serpean/toyota-keys/3mf/avensis_3_botones.3mf

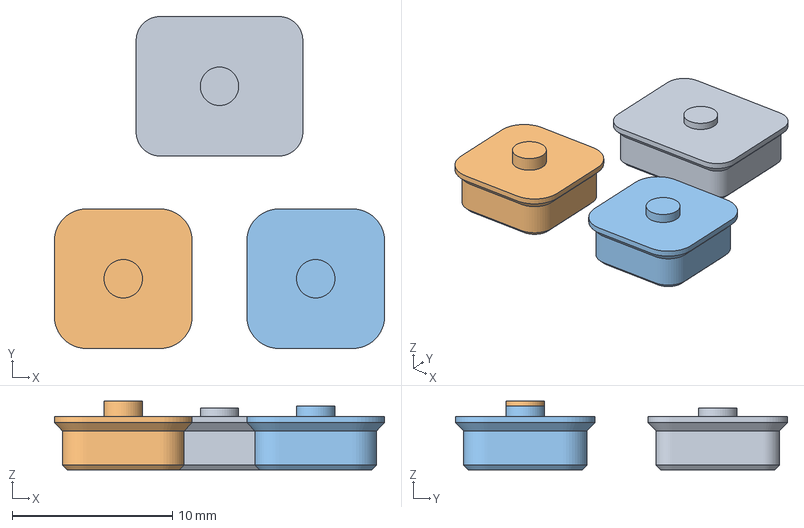
[picture p5: CAD file, 2026-11-06]
3mf/avensis_3_botones.3mf
20.6 x 20.7 x 4.30 mm
pieza_1
pieza_2
pieza_3
