serpean/toyota-keys/3mf/prueba_holgura_3_juegos.3mf

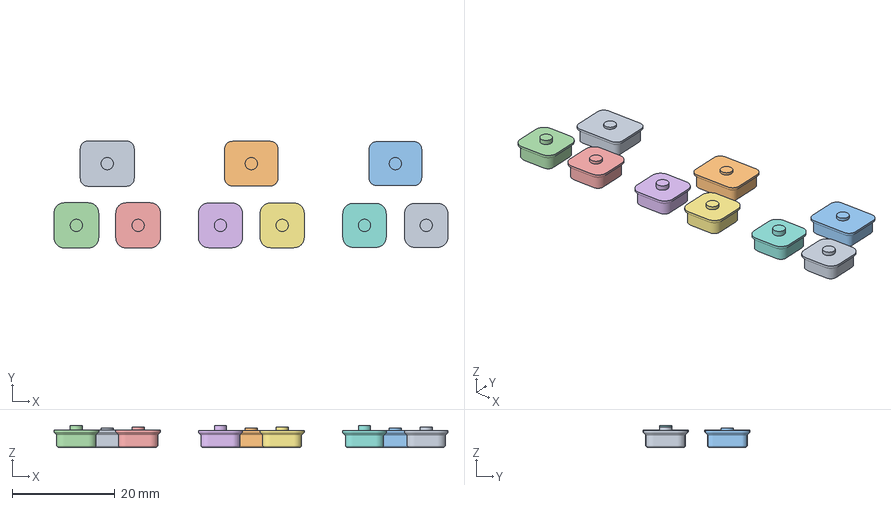
[picture p6: CAD file, 2026-11-06]
3mf/prueba_holgura_3_juegos.3mf
76.6 x 20.8 x 4.30 mm
pieza_1
pieza_2
pieza_3
pieza_4
pieza_5
pieza_6
pieza_7
pieza_8
pieza_9
