serpean/toyota-keys/3mf/boton_arriba_izq.3mf

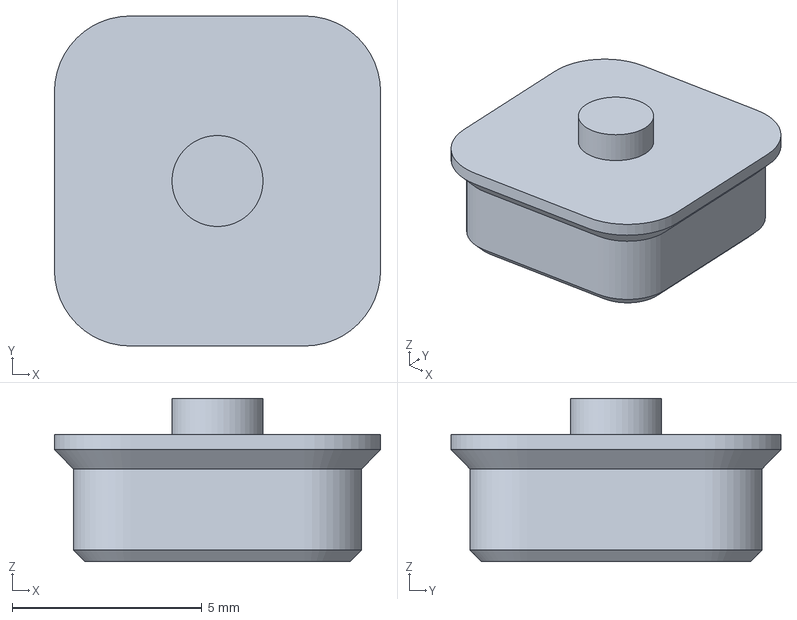
[picture p7: CAD file, 2026-11-06]
3mf/boton_arriba_izq.3mf
8.60 x 8.70 x 4.30 mm
