serpean/toyota-keys/3mf/boton_unlock.3mf

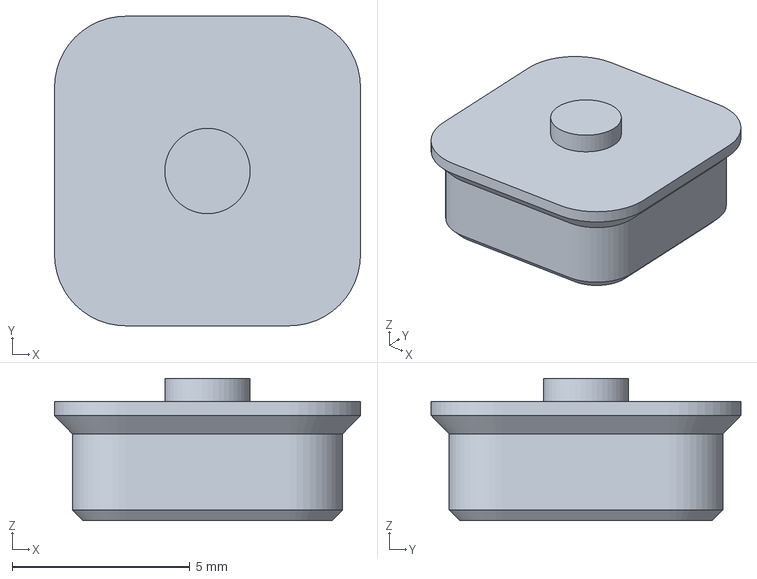
[picture p8: CAD file, 2026-11-06]
3mf/boton_unlock.3mf
8.60 x 8.70 x 4.00 mm
