serpean/toyota-keys/3mf/prueba_ancho_botones_arriba.3mf

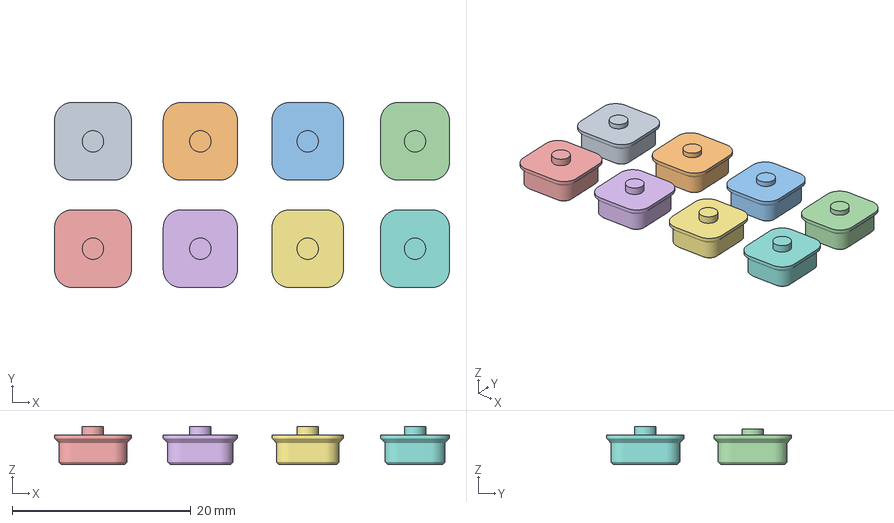
[picture p9: CAD file, 2026-11-06]
3mf/prueba_ancho_botones_arriba.3mf
44.2 x 20.7 x 4.30 mm
pieza_1
pieza_2
pieza_3
pieza_4
pieza_5
pieza_6
pieza_7
pieza_8
