serpean/toyota-keys/3mf/botones_arriba.3mf

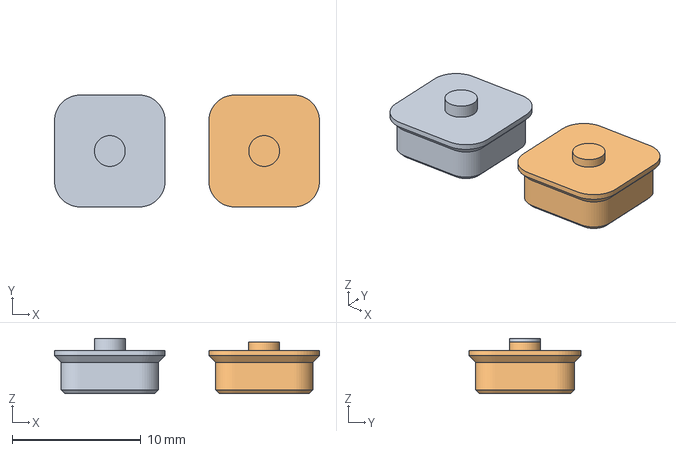
[picture p10: CAD file, 2026-11-06]
3mf/botones_arriba.3mf
20.6 x 8.70 x 4.30 mm
pieza_1
pieza_2
