serpean/toyota-keys/3mf/boton_lock.3mf

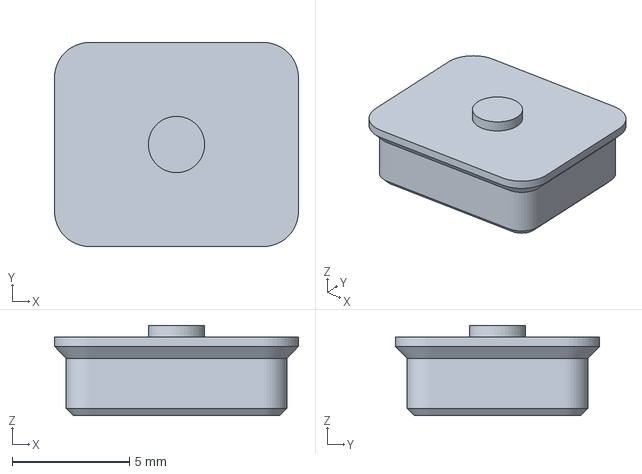
[picture p11: CAD file, 2026-11-06]
3mf/boton_lock.3mf
10.4 x 8.70 x 3.85 mm
