serpean/toyota-keys/(list of files, cad)

Other CAD files:
stl/avensis_3_botones.stl
stl/boton_arriba_izq.stl
stl/boton_lock.stl
stl/boton_unlock.stl
stl/botones_arriba.stl
stl/prueba_ancho_botones_arriba.stl
stl/prueba_holgura_3_juegos.stl
