serpean/toyota-keys/(commit log)

2026-11-01 Botones 3D imprimibles para mando Toyota Avensis 2005 (3 botones)
    Modelo OpenSCAD parametrico de botones tapon que encajan en los agujeros
    de la goma rota, piezas de prueba de ajuste, STL exportados y guia de
    impresion para Bambu Lab P2S con boquilla 0.2 mm.
    Claude-Session: https://claude.ai/code/session_014tzpEWmsZxeVS92H5gnn2N
    [avensis_3_botones.stl, avensis_botones.scad, boton_arriba_izq.stl, boton_lock.stl, boton_unlock.stl, prueba_ajuste.stl]
2026-11-01 STL en binario y versiones 3MF con objetos separados
    Los STL ASCII (hasta 2,4 MB) podian llegar truncados al descargarlos; ahora
    son binarios y se anaden 3MF con cada boton como objeto independiente.
    Corrige la descripcion de filas de la prueba de ajuste en el README.
    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
    [avensis_3_botones.3mf, avensis_3_botones.stl, boton_arriba_izq.3mf, boton_arriba_izq.stl, boton_lock.3mf, boton_lock.stl, boton_unlock.3mf, boton_unlock.stl]
2026-11-01 v2: botones con pestana interior y medidas reales de la llave
    Los agujeros resultaron ser ventanas en la carcasa rigida, no en la goma.
    Nuevo diseno: el boton entra por dentro, asoma por la ventana y una pestana
    con chaflan a 45 grados lo retiene. Medidas con calibre: ventanas 8,3x8,0 /
    8,3x8,0 / 9,7x8,0, carcasa 1,8 mm, profundidad al pulsador 3,65 / 3,35 /
    3,20 mm. Incluye prueba con 3 juegos de holgura, dibujo de montaje nuevo y
    README actualizado.
    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
    [avensis_3_botones.3mf, avensis_3_botones.stl, avensis_botones.scad, boton_arriba_izq.3mf, boton_arriba_izq.stl, boton_lock.3mf, boton_lock.stl, boton_unlock.3mf]
2026-11-01 Prueba de ancho para los botones de arriba
    Los botones arriba-izquierda y UNLOCK no entraban con ventana de 8,3 mm.
    Nueva pieza de prueba con anchos 7,9 / 7,6 / 7,3 / 7,0 mm y esquinas
    mas redondeadas (r 1,5), marcados con 1-4 puntos.
    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
    [avensis_botones.scad, prueba_ancho_botones_arriba.3mf, prueba_ancho_botones_arriba.stl]
2026-11-01 Botones de arriba con ventana de 7,9 mm y archivo solo con esos dos
    Con 8,3 mm no entraban. Se ajusta el modelo a 7,9 x 8,0 con esquinas r 1,5
    (juego de 1 punto de la prueba de ancho) y se anade botones_arriba.3mf.
    Corrige en el README que filas son de cada boton en la prueba de ancho.
    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
    [avensis_3_botones.3mf, avensis_3_botones.stl, avensis_botones.scad, boton_arriba_izq.3mf, boton_arriba_izq.stl, boton_unlock.3mf, boton_unlock.stl, botones_arriba.3mf]
2026-11-06 Botones mas bajos: asoman 0,8 mm en vez de 1,5 mm
    Con 1,5 mm sobresalian demasiado de la carcasa. La pestana y el pivote no
    cambian. Se regeneran todos los STL/3MF, las vistas y el dibujo de montaje.
    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
    [avensis_3_botones.3mf, avensis_3_botones.stl, avensis_botones.scad, boton_arriba_izq.3mf, boton_arriba_izq.stl, boton_lock.3mf, boton_lock.stl, boton_unlock.3mf]
